jhugon/kicad_STM32F0-32pin-USBC/README.md

# KiCad STM32F0 32-pin with USB

A breakout board for a STM32F0 with 32 pins, connected to a UART-to-USB chip
and USB-C port.

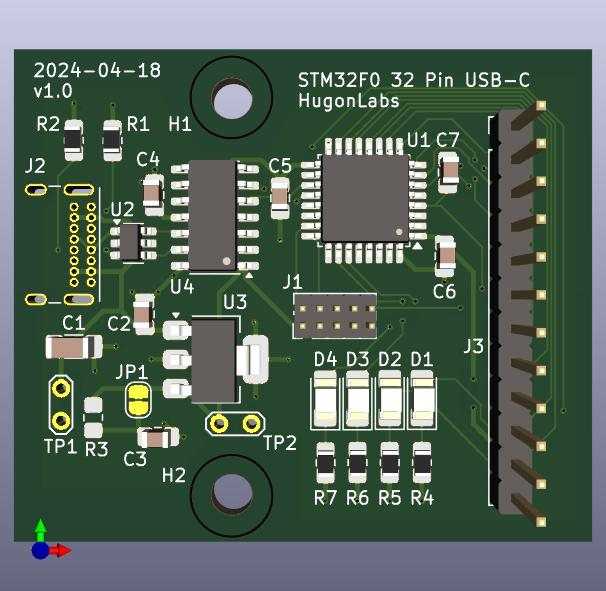
[picture p1: STM32F0-32pin-USBC_render_front.jpg]
Front PCB render


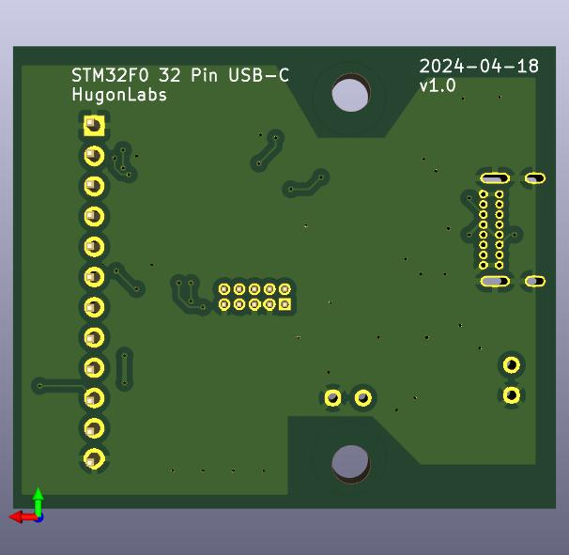
[picture p2: STM32F0-32pin-USBC_render_back.jpg]
Back PCB render
