jhugon/kicad_STM32F0-32pin-USBC/STM32F0-32pin-USBC_pcb.pdf

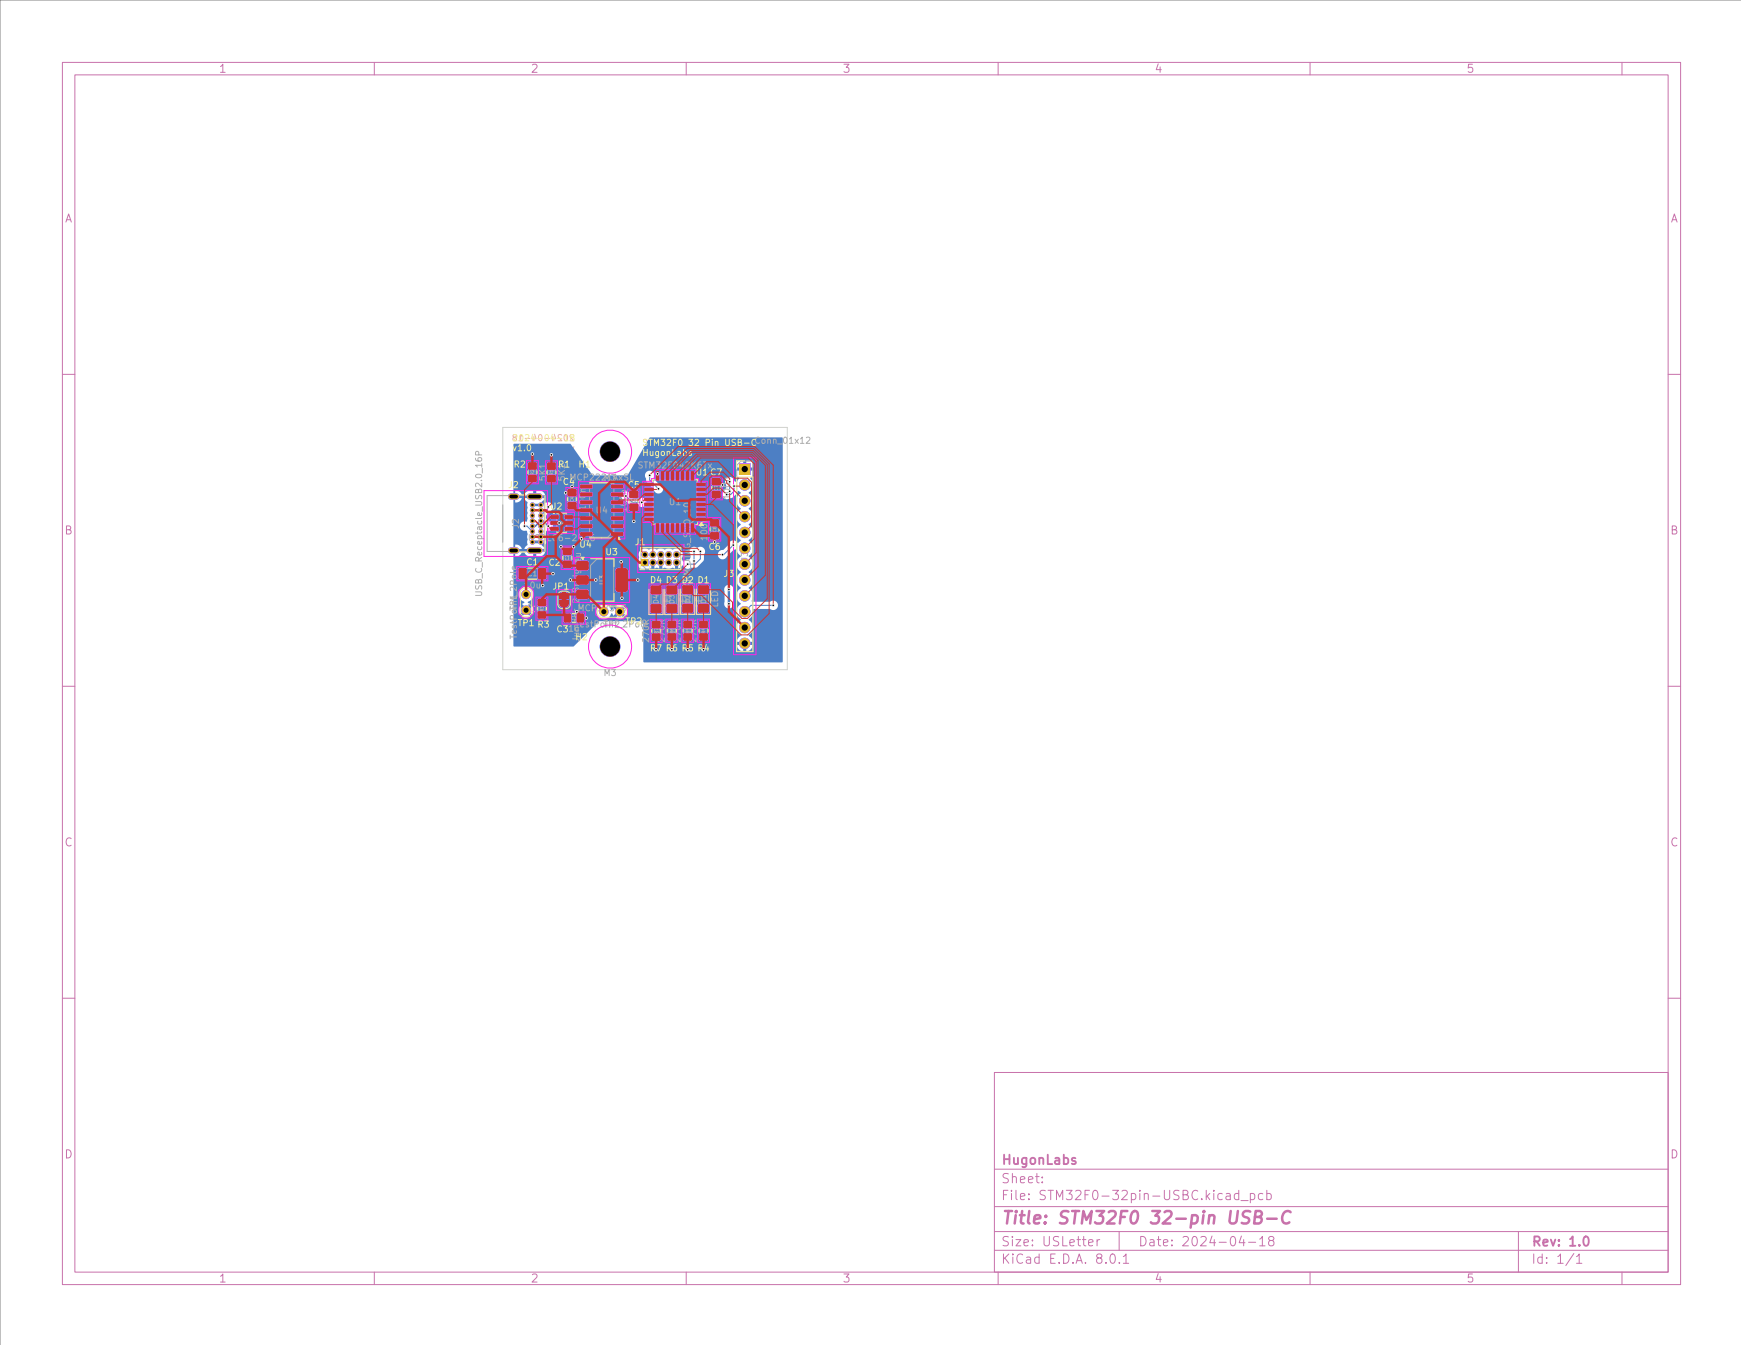
[picture p3: page 1]
