jhugon/kicad_STM32F0-32pin-USBC/STM32F0-32pin-USBC_sch.pdf

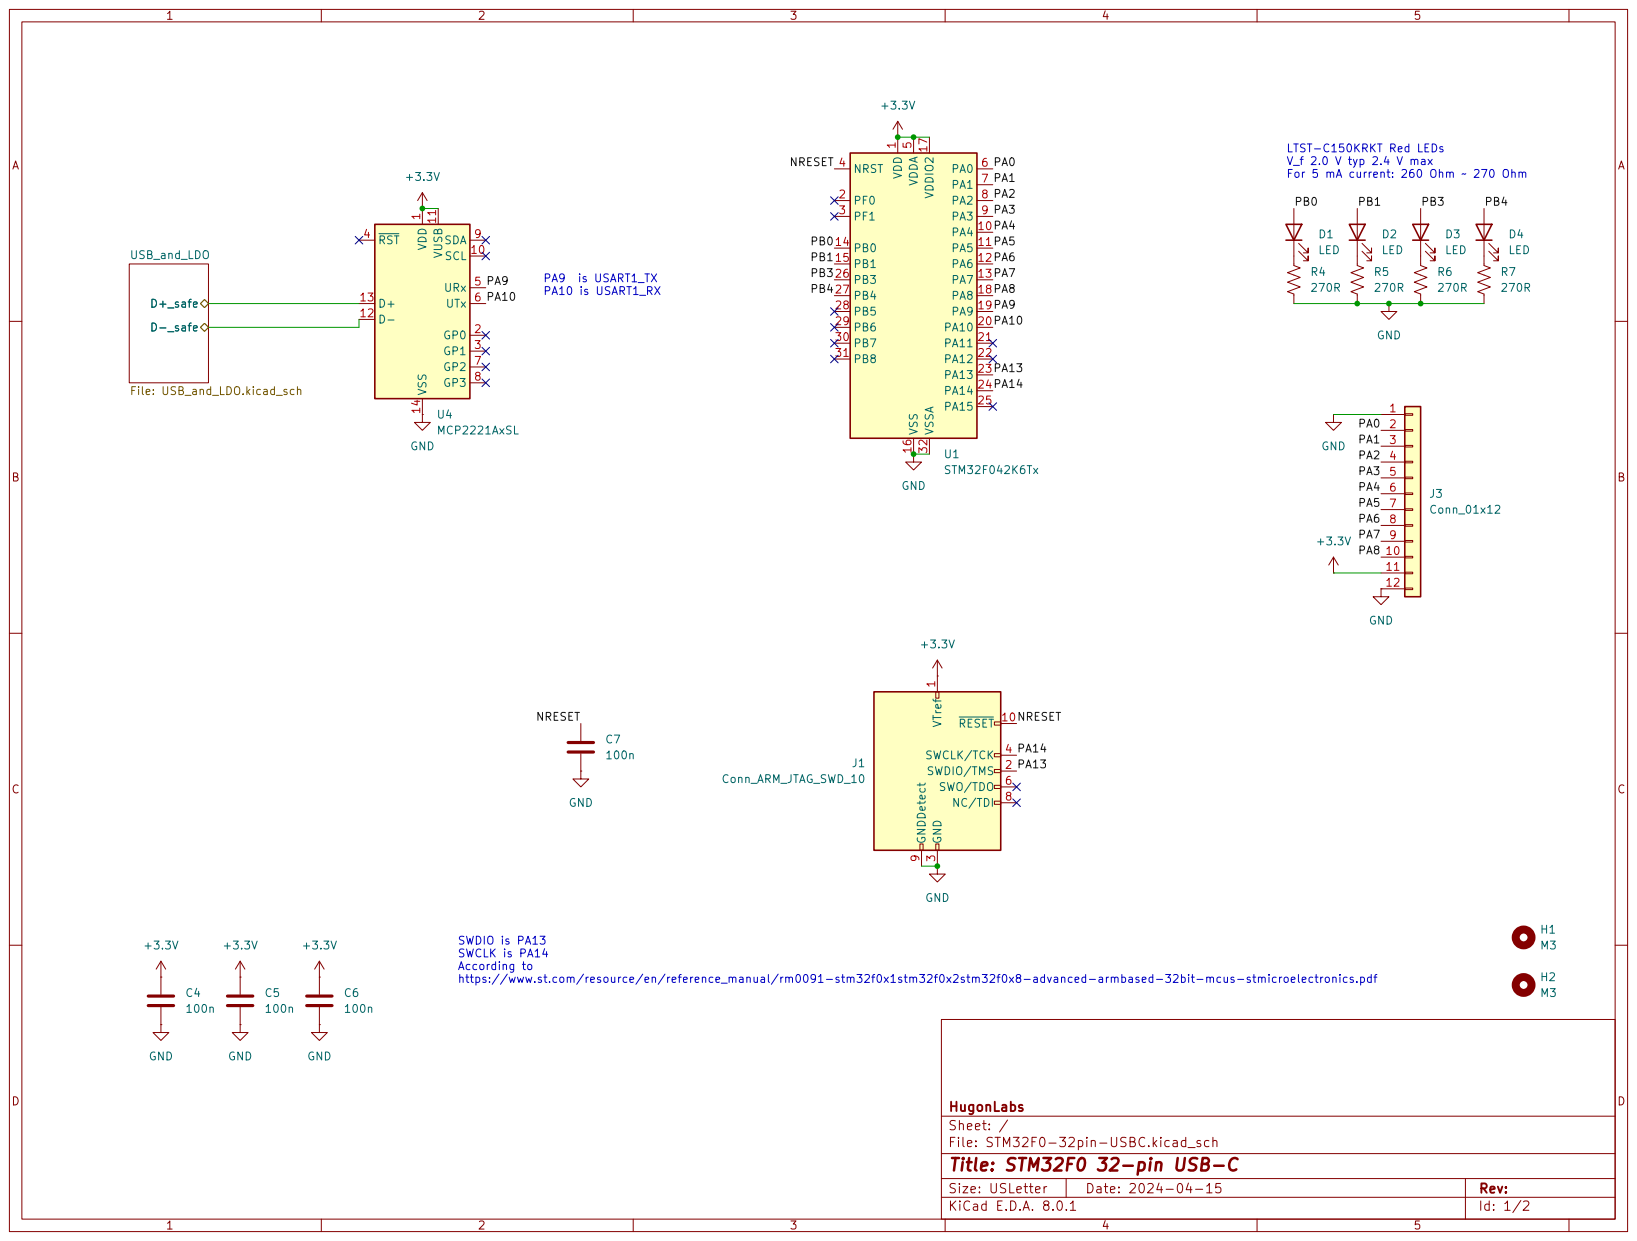
[picture p4: page 1]

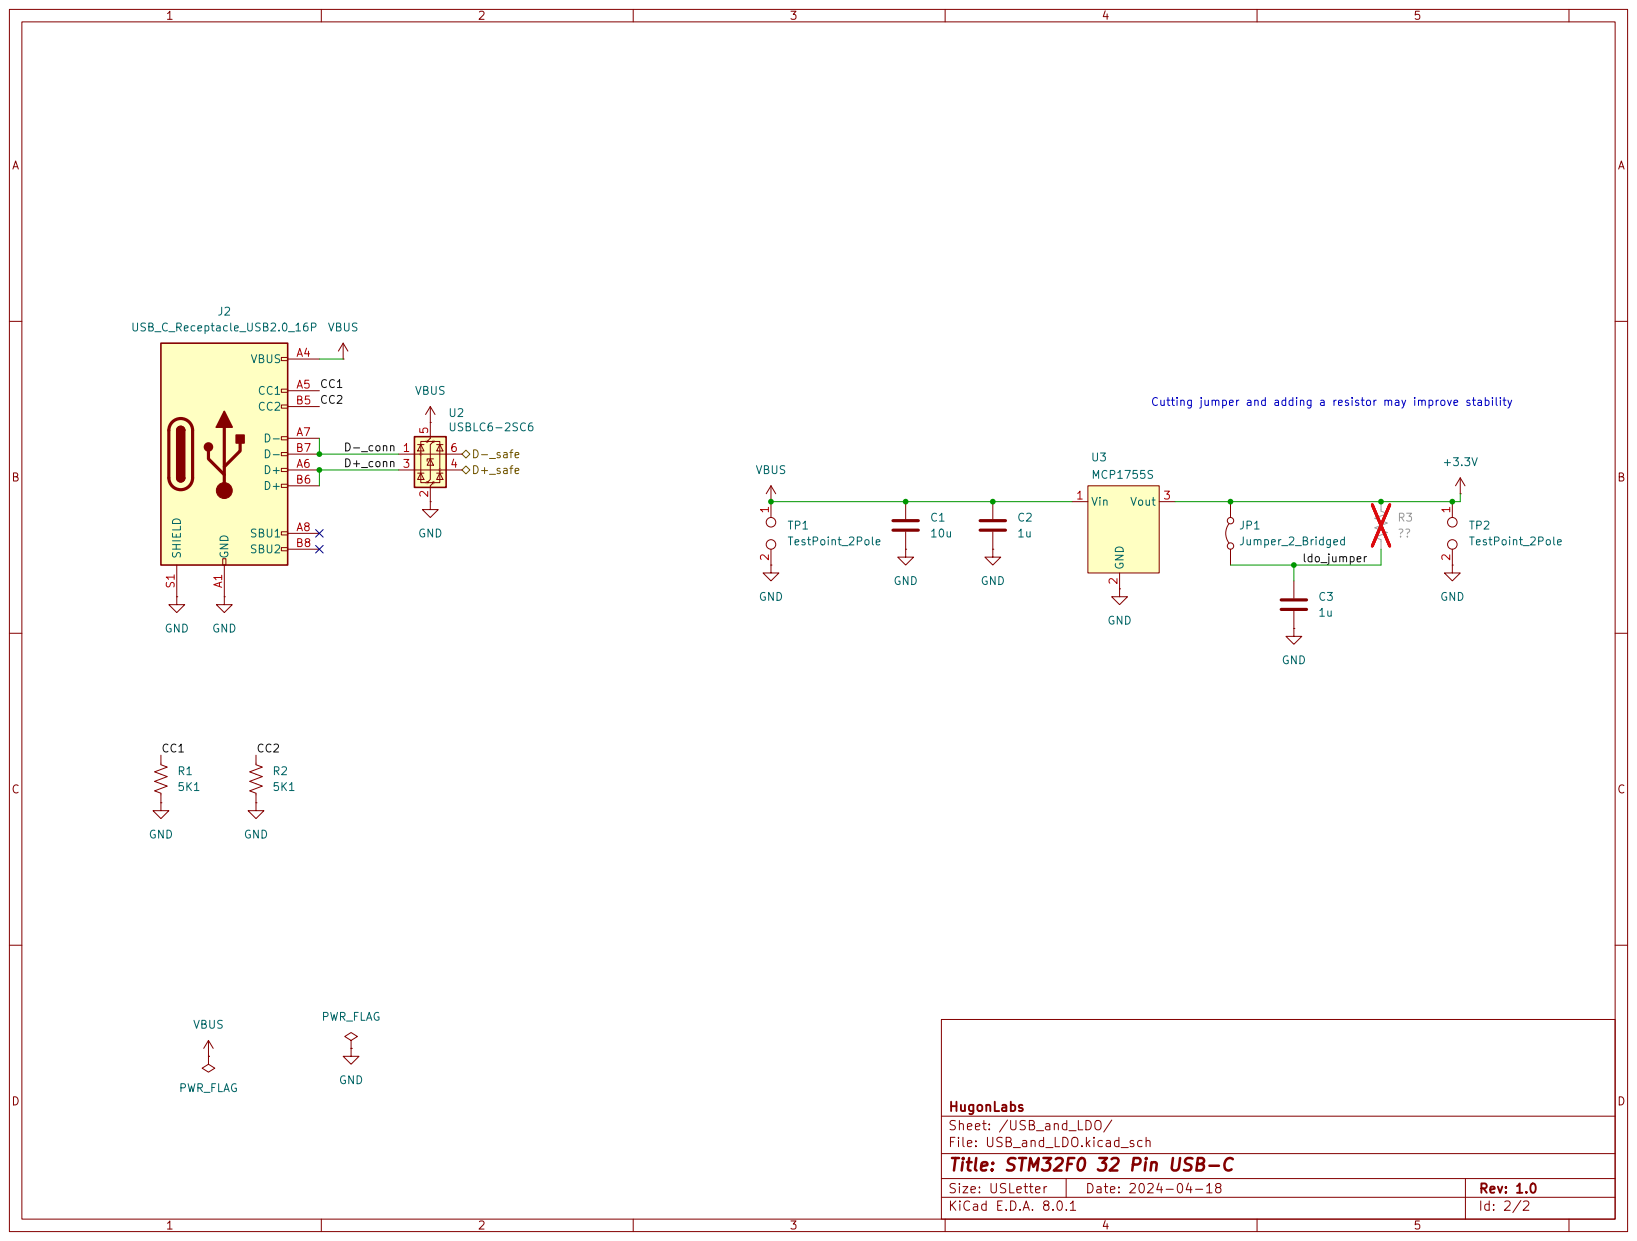
[picture p5: page 2]
