jhugon/kicad_STM32F0-32pin-USBC/STM32F0-32pin-USBC.kicad_pcb

## KiCad design STM32F0-32pin-USBC.kicad_pcb (2024-04-20)

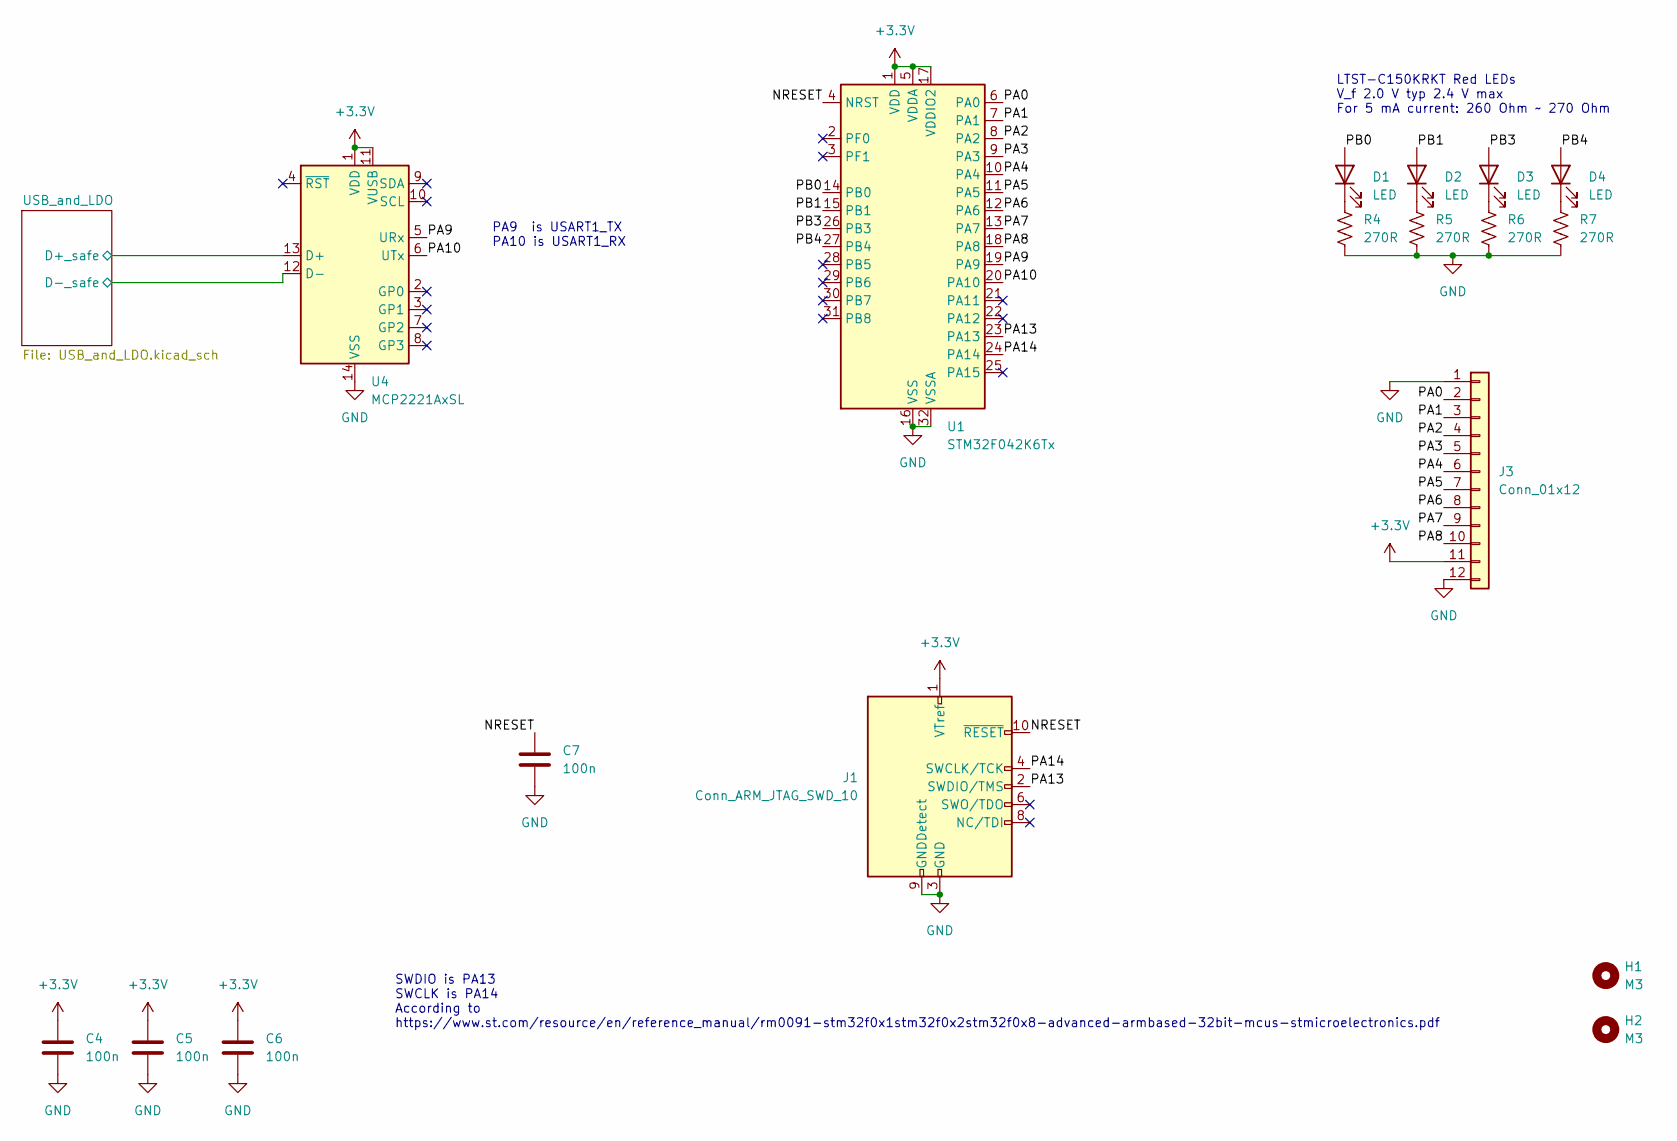
[picture p6: schematic STM32F0-32pin-USBC.kicad_sch, STM32F0 32-pin USB-C]

Parts:
C4, C5, C6, C7: 100n; C_0805_2012Metric_Pad1.18x1.45mm_HandSolder; MFR Part No C0805C104K4RACTU
D1, D2, D3, D4: LED; LED_1206_3216Metric_Pad1.42x1.75mm_HandSolder; MFR Part No LTST-C150KRKT
H1, H2: M3; MountingHole_3.2mm_M3
J1: Conn_ARM_JTAG_SWD_10; PinHeader_2x05_P1.27mm_Vertical; MFR Part No FTSH-105-01-L-D-007-K
J3: Conn_01x12; PinHeader_1x12_P2.54mm_Vertical; MFR Part No 9-146285-0
R4, R5, R6, R7: 270R; R_0805_2012Metric_Pad1.20x1.40mm_HandSolder; MFR Part No CRCW0805270RFKEA
U1: STM32F042K6Tx; LQFP-32_7x7mm_P0.8mm; MFR Part No STM32F042K6T6
U4: MCP2221AxSL; SOIC-14_3.9x8.7mm_P1.27mm; MFR Part No MCP2221A-I/SL

Connections:
+3.3V: C4.1, C5.1, C6.1, J1.1 (VTref), J3.11, U1.1 (VDD), U1.5 (VDDA), U1.17 (VDDIO2), U4.1 (VDD), U4.11 (VUSB); also elsewhere on the board
/NRESET: C7.1, J1.10 (~RESET), U1.4 (NRST)
/PA0: J3.2, U1.6 (PA0)
/PA1: J3.3, U1.7 (PA1)
/PA2: J3.4, U1.8 (PA2)
/PA3: J3.5, U1.9 (PA3)
/PA4: J3.6, U1.10 (PA4)
/PA5: J3.7, U1.11 (PA5)
/PA6: J3.8, U1.12 (PA6)
/PA7: J3.9, U1.13 (PA7)
/PA8: J3.10, U1.18 (PA8)
/PA9: U1.19 (PA9), U4.5 (URx)
/PA10: U1.20 (PA10), U4.6 (UTx)
/PA13: J1.2 (SWDIO/TMS), U1.23 (PA13)
/PA14: J1.4 (SWCLK/TCK), U1.24 (PA14)
/PB0: D1.2 (A), U1.14 (PB0)
/PB1: D2.2 (A), U1.15 (PB1)
/PB3: D3.2 (A), U1.26 (PB3)
/PB4: D4.2 (A), U1.27 (PB4)
/USB_and_LDO/D+_safe: U4.13 (D+); also elsewhere on the board
/USB_and_LDO/D-_safe: U4.12 (D-); also elsewhere on the board
GND: C4.2, C5.2, C6.2, C7.2, J1.3 (GND), J1.5 (GND), J1.9 (GNDDetect), J3.1, J3.12, R4.2, R5.2, R6.2, R7.2, U1.16 (VSS), U1.32 (VSSA), U4.14 (VSS); also elsewhere on the board
unnamed: D1.1 (K), R4.1
unnamed: D2.1 (K), R5.1
unnamed: D3.1 (K), R6.1
unnamed: D4.1 (K), R7.1

Notes on the sheet:
SWDIO is PA13 SWCLK is PA14 According to https://www.st.com/resource/en/reference_manual/rm0091-stm32f0x1stm32f0x2stm32f0x8-advanced-armbased-32bit-mcus-stmicroelectronics.pdf
LTST-C150KRKT Red LEDs V_f 2.0 V typ 2.4 V max For 5 mA current: 260 Ohm ~ 270 Ohm
PA9 is USART1_TX PA10 is USART1_RX

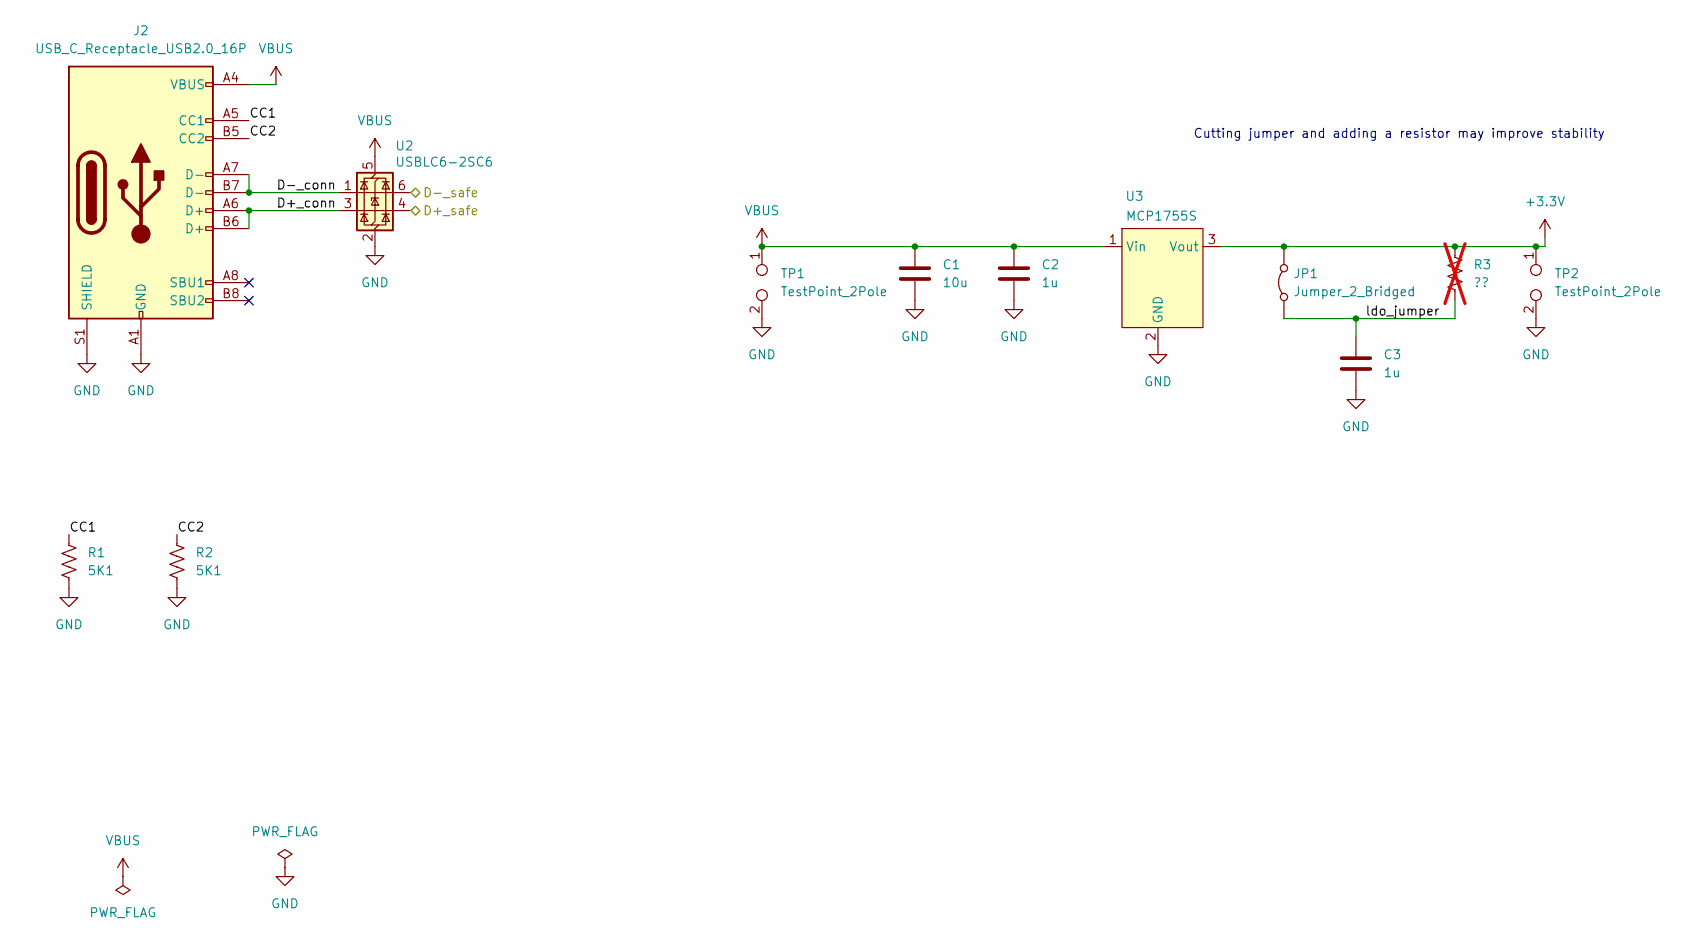
[picture p7: schematic USB_and_LDO.kicad_sch, STM32F0 32 Pin USB-C]

Parts:
C1: 10u; C_1206_3216Metric_Pad1.33x1.80mm_HandSolder; MFR Part No C1206C106K4RACTU
C2, C3: 1u; C_0805_2012Metric_Pad1.18x1.45mm_HandSolder; MFR Part No C0805C105K4RACTU
J2: USB_C_Receptacle_USB2.0_16P; USB_C_Receptacle_GCT_USB4085_Reduced_Pad_Size; MFR Part No USB4085-GF-A
JP1: Jumper_2_Bridged; SolderJumper-2_P1.3mm_Bridged_RoundedPad1.0x1.5mm
R1, R2: 5K1; R_0805_2012Metric_Pad1.20x1.40mm_HandSolder; MFR Part No CRCW08055K10FKEA
R3: ??; R_0805_2012Metric_Pad1.20x1.40mm_HandSolder; not fitted
TP1, TP2: TestPoint_2Pole; TestPoint_2Pads_Pitch2.54mm_Drill0.8mm
U2: USBLC6-2SC6; SOT-23-6; MFR Part No USBLC6-2SC6
U3: MCP1755S; SOT-223-3_TabPin2; MFR Part No MCP1755S-XX02E/DB

Connections:
+3.3V: JP1.2 (B), R3.1, TP2.1, U3.3 (Vout); also elsewhere on the board
/USB_and_LDO/CC1: J2.A5 (CC1), R1.1
/USB_and_LDO/CC2: J2.B5 (CC2), R2.1
/USB_and_LDO/D+_conn: J2.A6 (D+), J2.B6 (D+), U2.3 (I/O2)
/USB_and_LDO/D+_safe: U2.4 (I/O2); also elsewhere on the board
/USB_and_LDO/D-_conn: J2.A7 (D-), J2.B7 (D-), U2.1 (I/O1)
/USB_and_LDO/D-_safe: U2.6 (I/O1); also elsewhere on the board
/USB_and_LDO/ldo_jumper: C3.1, JP1.1 (A), R3.2
GND: C1.2, C2.2, C3.2, J2.A1 (GND), J2.A12 (GND), J2.B1 (GND), J2.B12 (GND), J2.S1 (SHIELD), R1.2, R2.2, TP1.2, TP2.2, U2.2 (GND), U3.2 (GND); also elsewhere on the board
VBUS: C1.1, C2.1, J2.A4 (VBUS), J2.A9 (VBUS), J2.B4 (VBUS), J2.B9 (VBUS), TP1.1, U2.5 (VBUS), U3.1 (Vin)

Notes on the sheet:
Cutting jumper and adding a resistor may improve stability

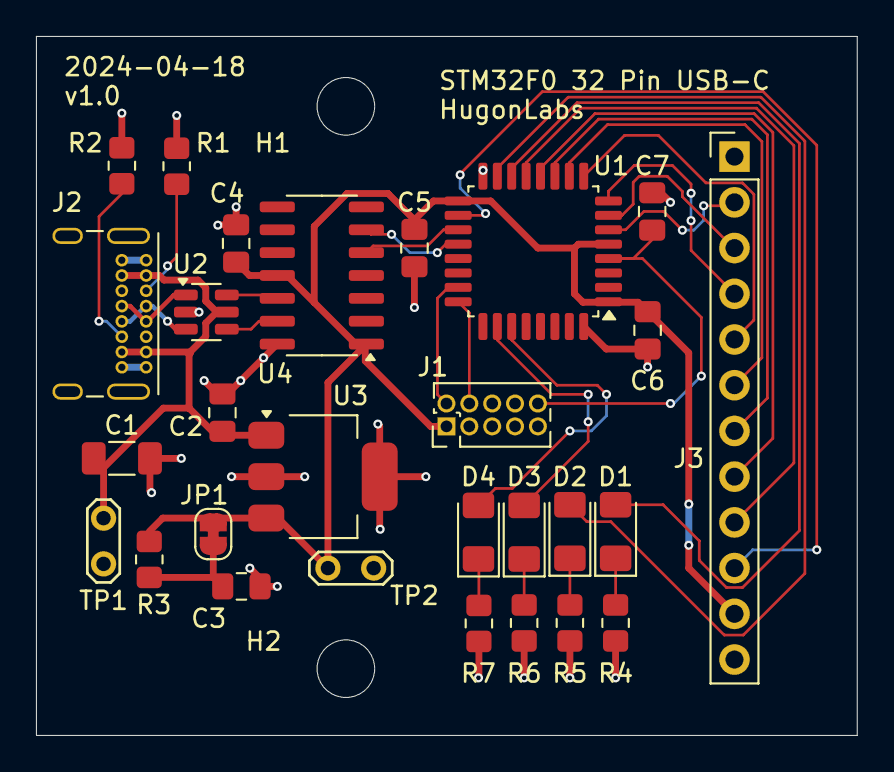
[picture p8: board STM32F0-32pin-USBC.kicad_pcb from above]

Board: 2 copper layers, 45.6 x 38.8 mm, 30 parts (0 on the bottom side), 32 nets.
