jhugon/kicad_STM32F0-32pin-USBC/(commit log)

2024-04-05 Setup pages and PCB settings for OSHPark
    [STM32F0-32pin-USBC.kicad_pcb, STM32F0-32pin-USBC.kicad_sch]
2024-04-05 Added kicad_hugonlib submodule and added libs to project
    [STM32F0-32pin-USBC.kicad_sch]
2024-04-05 Added symbols and completed USB_and_LDO sheet
    [STM32F0-32pin-USBC.kicad_sch, USB_and_LDO.kicad_sch]
2024-04-05 work on schematic
    [STM32F0-32pin-USBC.kicad_sch, USB_and_LDO.kicad_sch]
2024-04-15 Finished schematic; ERC pass; still need footprints and part nums
    [STM32F0-32pin-USBC.kicad_sch]
2024-04-15 Added all footprints
    [STM32F0-32pin-USBC.kicad_sch, USB_and_LDO.kicad_sch]
2024-04-15 finished part nubers in BOM
    [STM32F0-32pin-USBC.kicad_pcb, STM32F0-32pin-USBC.kicad_sch, USB_and_LDO.kicad_sch]
2024-04-16 preliminary footprint placement
    [STM32F0-32pin-USBC.kicad_pcb, STM32F0-32pin-USBC.kicad_sch, USB_and_LDO.kicad_sch]
2024-04-16 everything routed but ground
    [STM32F0-32pin-USBC.kicad_pcb, USB_and_LDO.kicad_sch]
2024-04-16 routing done; many ERC violations
    [STM32F0-32pin-USBC.kicad_pcb]
2024-04-16 switched to small pad size usb conn and drew board edge
    [STM32F0-32pin-USBC.kicad_pcb, USB_and_LDO.kicad_sch]
2024-04-18 update all R's and all C's but 10u to 0805 from 1206
    [STM32F0-32pin-USBC.kicad_pcb, STM32F0-32pin-USBC.kicad_sch, USB_and_LDO.kicad_sch]
2024-04-18 Changed to 0805 for most Rs and C's
    [STM32F0-32pin-USBC.kicad_pcb, USB_and_LDO.kicad_sch]
2024-04-18 fixed DRC violations
    [STM32F0-32pin-USBC.kicad_pcb]
2024-04-20 silenced another ERC check
    [STM32F0-32pin-USBC.kicad_pcb]
